sgadhiya45/Acceleration-Measurement/Simulation/Simulation_test-circuit_LT-Spice.pdf

## Simulation test circuit in LT-SPICE

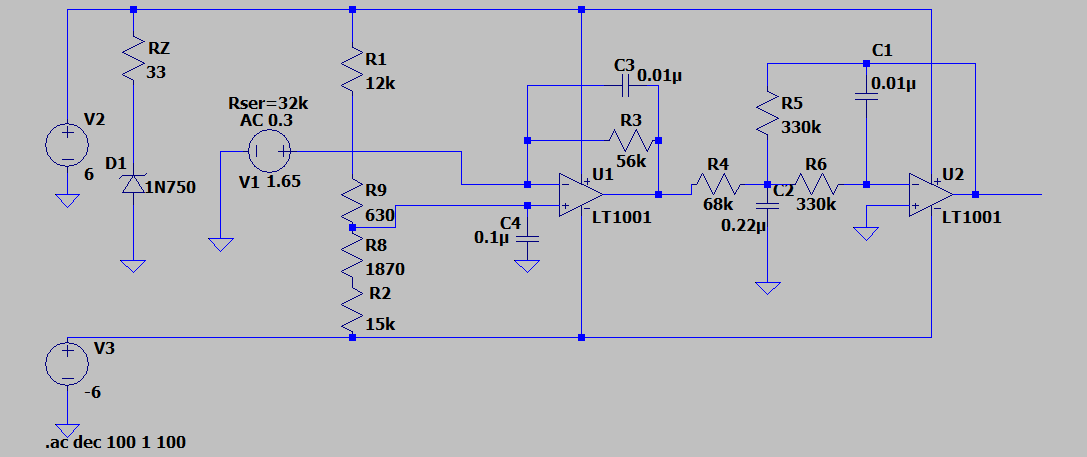
[picture p3: figure]

The simulation of circuit was done in Ltspice (from Linear Technology) software package from the SPICE family with a graphical input of circuit diagrams and a graphical output presenting the simulation results before building the circuit hardware. In place of sensor a voltage source with a series resistance Rs=32 kΩ has been used which replicates the sensor.
