sgadhiya45/Acceleration-Measurement/report/Accelerations_Measurement.pdf

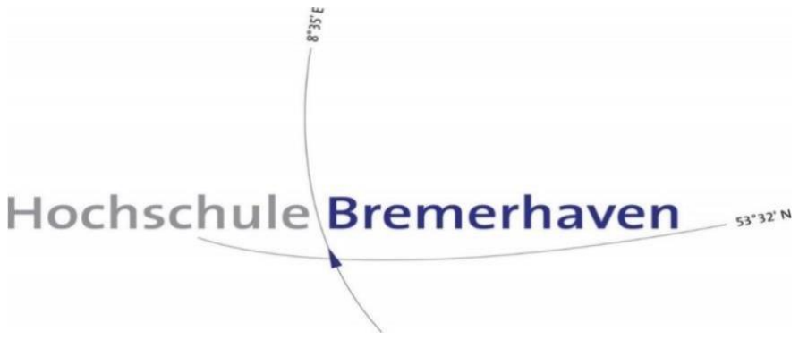
[picture p4: figure]

### M.S in Embedded Systems Design

## Maritime Systems

## Under the guidance of Prof. Dr. Axel Bochert

## Laboratory Report

## Acceleration Measurement

## Submitted by:

## Sumit Gadhiya (38710)

Date of submission: 18-09-2023

Contents

ESD Hochschule Bremerhaven | i

## Contents

Summary | 1
1. Overview | 1
2. Hardware basics | 2
2.1 | Acceleration sensor/ Sensor module | 2
2.2 | Microcontroller ATmega32 | 3
2.3 | Circuit assembly | 3
3. Measurement of the cut-off frequency | 5
3.1 | Using sine wave | 5
3.2 | Using step response | 5
4. Acceleration measurement in the elevator | 7
4.1 | Calibration process | 7
4.2 | Derivation of velocity and displacement | 9
4.3 | Correction of the temporal drift | 11
4.4 | Calculation of displacement | 12
5. Result | 13
6. Conclusion | 14
References | 15

### Abbreviation

AC : Alternating current | 5
AVR : Automatic Voltage Regulator | 3
DC : Direct Current | 5
GND : Ground | 3
PCB : Printed Circuit Board | 1
RISC : Reduced Instruction Set Computer | 3
SD card : Secure Digital Memory Card | 1
MEMS : Micro Electric Mechanical System | 3

Summary

ESD Hochschule Bremerhaven | 1

## Summary

The goal of the experiment is to calculate the height of the floors by measuring the acceleration of an elevator trip.

The experiment includes multiple phases, including designing and simulating a circuit in LTspice, creating a circuit on a PCB, programming a microcontroller, measuring acceleration data, processing it, and recording it on an SD card with the help of a microcontroller.

To improve accuracy, several elevator rides were taken and the data examined. The measurements were then shown in MATLAB, and the floor height was determined by calculating the standard deviation of all the readings.

## 1. Overview

The circuit is built using a ADXL355 [1] from Analog Devices was used to measure the acceleration. A Zener diode (BZX85C4V7) [2] used for stabilizing the direct current voltages for operating the sensor. An operational amplifier (TLC272) [3] for amplification of the output signal and also an active low pass filter. Finally, the remaining components values are calculated assuming the Amplification value suited.

Before starting with the assembly of the circuit on the Printed Circuit Board (PCB), the circuit was simulated in LTspice to observe the behavior of design with the calculated values of the components.

Once done with the LTspice simulation for observing the frequency response of the circuit as expected with the circuit components selected. The components are soldered onto a PCB. After which instead of directly placing the sensor module on the PCB, it is tested with the power supply and a designed board used for depicting the sensor output voltage.

DSOX 2002A Oscilloscope from Agilent [4] is used for measuring the frequency response and the step function.

Then the designed circuit was integrated with an ATmega 32 microcontroller [5] which uses a C-code for storing the analog data which uses an Analog to Digital Converter (ADC) to store the data in SD card. The acquired data values are sent to the RS232 to save onto the SD card.

Then with help of batteries the whole circuit is powered and the acceleration readings are collected for the height of the floors to be calculated.

Hardware basics

## 2. Hardware basics

The following hardware components were included in this experiment:

### 2.1 Acceleration sensor/ Sensor module

Analog Devices' ADXL335 [1] is the acceleration sensor utilized in the experiment. It works on the basis of a mass pendulum in a micro electric mechanical system (MEMS). When the pendulum is distracted, internal capabilities are altered, affecting the output voltage. The level of the output voltage becomes the measure of acceleration because the relative movement of the pendulum is changed by the sensor's acceleration. These two variables are proportional to one other. The ADXL335 [1] is a three-axis acceleration sensor. Only one axis is necessary in this experiment.

With a typical sensitivity of s = 300 mV
g

and a 0 g bias level of Voff = 1.5 V, the acceleration

sensor can measure static and dynamic acceleration within a full-scale range of ±3 g. It can detect gravity's static acceleration as well as dynamic acceleration caused by motion, shock, or vibration in tilt-sensing applications. Figure 1 indicates the pin connections on the sensor module.

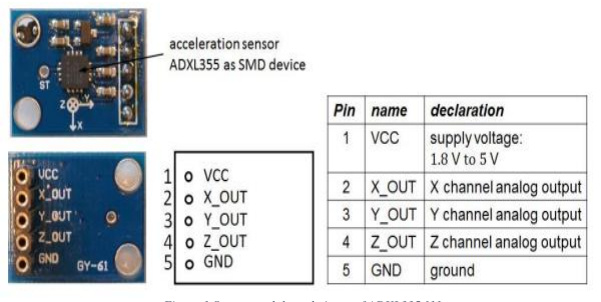
[picture p5: figure]

Figure 1 Sensor module and pinout of ADXL335 [1]

Hardware basics

### 2.2 Microcontroller ATmega32

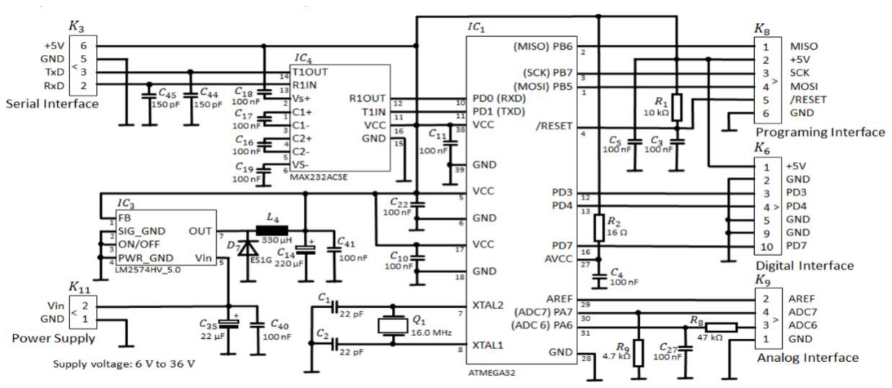
[picture p6: figure]

The Atmel® AVR® ATmega32 is a low-power CMOS 8-bit microcontroller based on the Automatic Voltage Regulator (AVR), enhanced Reduced Instruction Set Computer (RISC) architecture. In this experiment, the ATmega32 [5] microcontroller was used.
The board is suited for the experiment since it has an inbuilt 10-bit analog to digital converter (ADC), an RS232 communication port, and digital inputs and outputs. The above Figure 2 shows a circuit schematic for the microcontroller board.

### 2.3 Circuit assembly

The circuit design has two stages (see Figure 3). The former consists of subtracting amplifier and later stage is inverting amplifier and active low-pass filter. The purpose of this circuit is to measure acceleration. The offset voltage of the accelerometer in the test circuit is 1.5 V. The elevator acceleration was set to between +1.5 g and -0.5 g, resulting in a maximum output voltage of 1.95 V and a minimum output voltage of 1.35 V from the sensor.

A Zener diode provides the appropriate voltage to the sensor moduleM1. The module provides a variable output voltage on pin 2 that is proportional to X-direction acceleration. Pin 5 serves as a ground (GND) for both the power supply and the output signal. The desired amplification converting the sensor module's output voltage to the test circuit's output voltage Vacc can be shared across both amplification stages. The subtracting amplifier's positive input can be adjusted to zero to erase the sensor module's offset voltage. The trimmer P1 may be used to modify the voltage divider.

The second amplifier phase is made up of an active second-order low-pass filter with multiple negative feedback. This low-pass filters out high-frequency acceleration impulses. This is required since the Analog signal will be transformed to a digital signal later.

Figure 2 Microcontroller ATmega32 circuit diagram [2]

Hardware basics

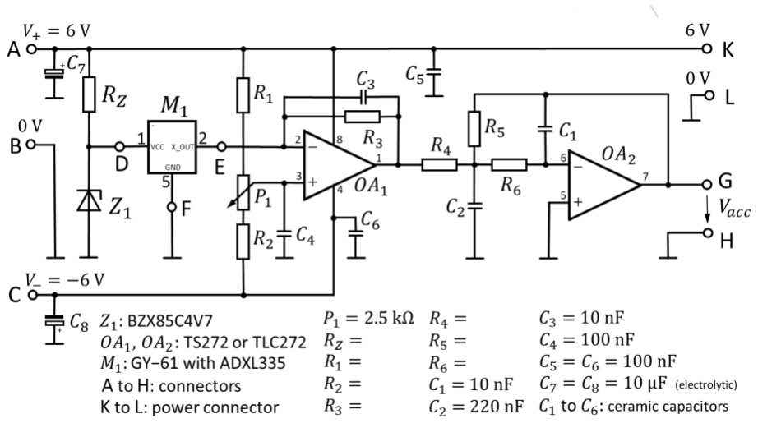
[picture p7: figure]

The power supply for the microcontroller experimental board used for data acquisition can be provided through connectors K and L. Figure 4 shows the test circuit diagram.

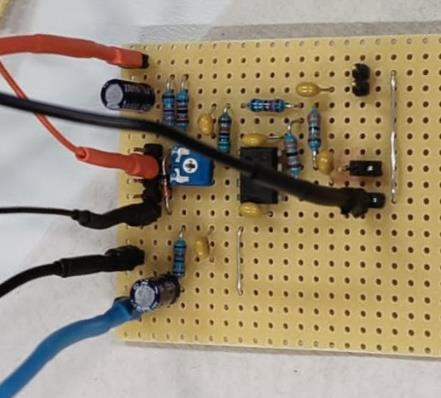
[picture p8: figure]
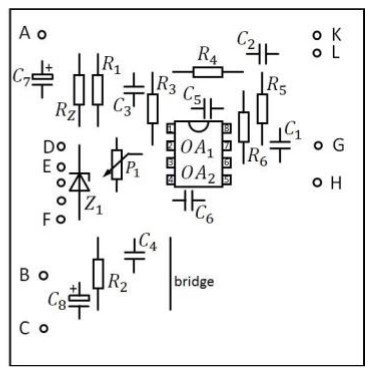
[picture p9: figure]

Figure 4: Positioning of the components on the experimental printed circuit board

Figure 3 Schematics of the test circuit with sensor module and operational amplifiers [2]

Measurement of the cut-off frequency

## 3. Measurement of the cut-off frequency

A waveform is generated with the help of an Agilent oscilloscope. There are two ways to calculate the frequency response of the circuit.
The following two approaches were used to determine the cut-off frequency.
1 Comparing the frequency response with the step response.
2 Creating a sign wave with the frequency response of a waveform generator

### 3.1 Using sine wave

An alternating current (AC) voltage is supplied to the circuit as replacement of the sensor module. The internal resistor of the sensor must be simulated using an external resistor. Then the output voltage is observed by changing the frequency.

The gain at the cut-off frequency can be derived with the direct current (DC)-gain:

gc =

g0
√2

=

7.08
√2
= 5.006 | (1)

The gain gc can be found at fc = 9.5 Hz (see Figure 5)

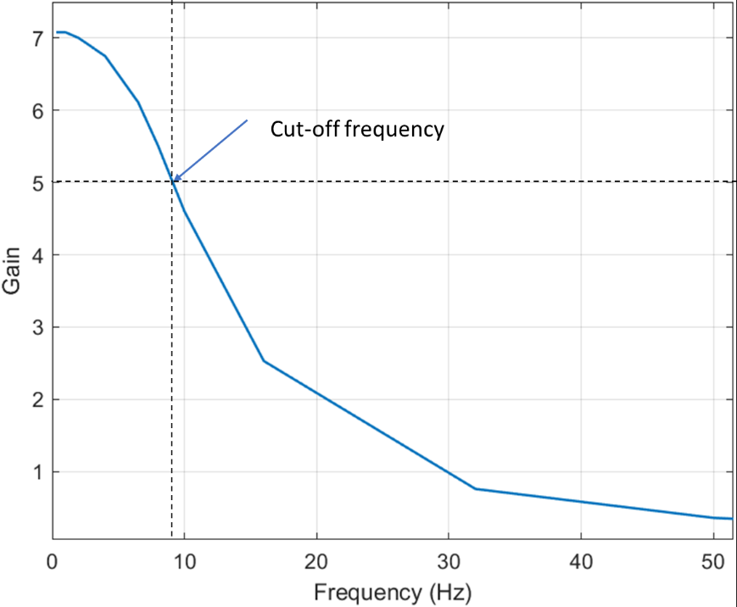
[picture p10: figure]

Figure 5 Sine wave frequency response

### 3.2 Using step response

Another way to calculate the cut-off frequency is using step response. Below diagram shows the square wave step response for the experimental circuit in oscilloscope screen.

Measurement of the cut-off frequency

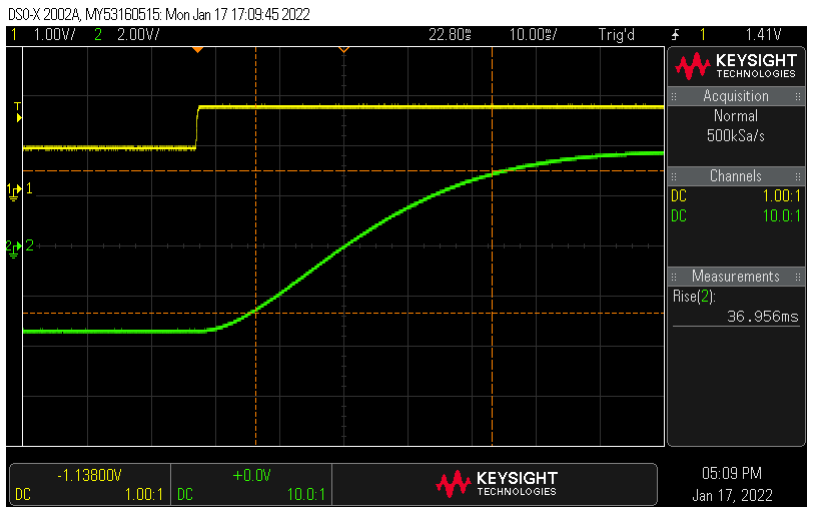
[picture p11: figure]

Slew rate ts
is the time between 10% to 90% of the output voltage which is measured automatically by the oscilloscope [4]. The cut-off frequency can be calculated as follows.

fc =

1
3∙ts

=

1
3∙36.956 ms
= 9.02 Hz | (2)

Both determination of the cut-off frequency fits into the designed cut-off frequency.

Figure 6: Step response of the experimental frequency

Acceleration measurement in the elevator

## 4. Acceleration measurement in the elevator

During the elevator travels, the battery was attached to the power supply connection on the experimental circuit. In order to achieve stability during the measurement, the experimental circuit was put and fastened with a wooden block. Using the RS232 interface, the measured data was sent and recorded to a micro-SD card. Figure 7 depicts the results of the elevator rides. After the circuit's functioning was confirmed, software measurements of acceleration during an elevator trip were recorded. In housing T of the University of Applied Sciences Bremerhaven, five elevator rides between the ground and 1

st floor were recorded. A calibration process was carried out before each journey in order to later calibrate the recorded data to the acceleration values of 0 g and 1 g.

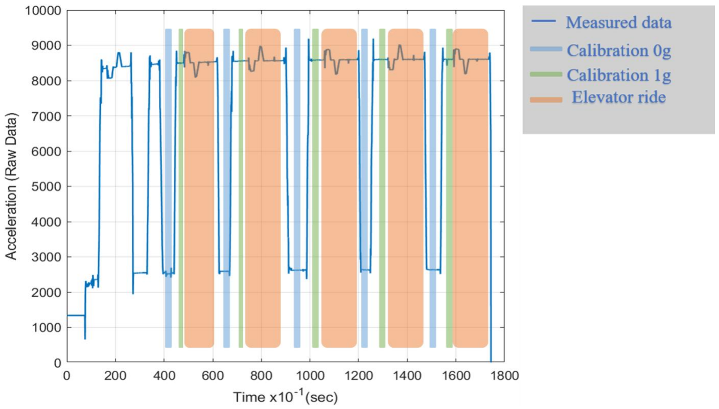
[picture p12: figure]

The first reading was discarded due to erroneous data.
a. At time 40s (color blue) acceleration due to gravity is 0 g. Sensor axis is in horizontal direction.
b. At time 43s (color green) acceleration due to gravity changes to 1 g. Sensor axis is tilted to vertical direction.
c. Between 45s to 65s (color orange section) is acceleration during elevator trip.

The following plot is repletion of the above steps. Calibration was performed after reaching every floor.

### 4.1 Calibration process

Raw data captured can’t be used directly for the calculation. The data logged contains the time and the output dacc from the ADC. This is nothing but the acceleration data in other means. Two known accelerations were collected before each trip to calibrate the recorded data.

Figure 7: Overview of recorded data

Acceleration measurement in the elevator

By tilting the sensor 90° to the floor, the first calibration point is 0 g. The sensor axis was then tilted in the direction of gravity to detect 1 g. To get a stable value, both calibration points were measured for 3 seconds. Both calibration stages were averaged arithmetically.

The below equation is used to calculate the acceleration.

a = k1 ∙ dacc + k0
(3)

Where,
a = Acceleration
k1 = co-efficient for proportionality
dacc = Output of analog to digital converter
k0 = co-efficient of the offset (m s

2 ⁄ )

By choosing two appropriate calibration sites of 0 g and 1 g, the coefficients k0 and k1 are calculated.

| Trip1 (dacc(value can be seen in tℎe raw data) )
Mean 0 g | 2550
Mean 1 g | 8596

Substituting these values in equation (4), we can derive following two equations.

For 0g: | 0 m s
2 ⁄ | = k1 ∙ 2550 + k0
(4)
For 1g: | 9.81 m s
2 ⁄ | = k1 ∙ 8842 + k0
(5)

From equation (5) and equation (6), we get,

k1 =

9.81 m s

2 ⁄
8842 − 2550 = 1.559 × 10⁻³ m/s

2

Substituting k1 we get k0
k0 = −k1 ∙ 2550 = −4.1375 m/s

2

The actual acceleration can be determined by using k0, k1, and dacc for all of the recorded values (Refer to equation 3).

Acceleration measurement in the elevator

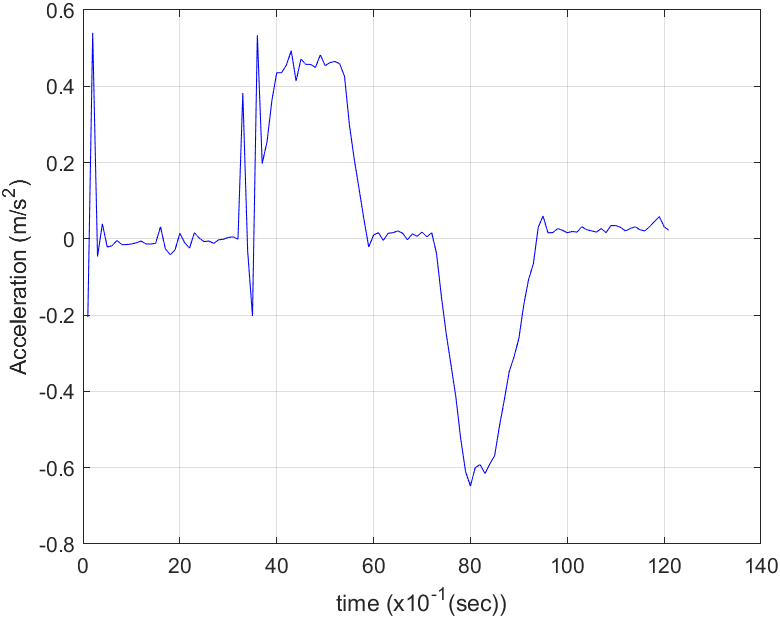
[picture p13: figure]

Figure 8 Acceleration Data

As a result, the raw acceleration data is transformed to m⁄s

2
after calibration, as illustrated in Figure 8.

The acceleration data for a single-direction movement, such as moving from the ground floor to 1

st floor, is displayed below.

### 4.2 Derivation of velocity and displacement

Using fundamental physics and mathematics concepts, the height of the floors can be computed from the acceleration data.

As we all know, an object's acceleration is defined as the rate at which its velocity changes, and velocity may be further defined as the rate at which its displacement varies over time.

The mathematical formula for acceleration (a), velocity (v), and displacement (s) are provided below.

a =

dv
dt

### and v =

ds
dt

Acceleration measurement in the elevator

From the above equations we have

v = ∫ a ∙ dt + v0

t
0

and s = ∫ v ∙ dt + s0

t
0

Where,
s0 = Initial displacement at time t = 0
v0 = Initial velocity at t = 0

Since we have discrete time systems, the above equations are replaced by summation:

vk = ∑ ai
- ∆t + v0

k
0

(6)

Where,
vk = Velocity at instance T
ai = acceleration at instance i
∆t = Time between two measurements

sk = ∑ vi
- ∆t + s0

k
0

(7)

Where,
S = Displacement at instance T
vi = acceleration at instance i
∆t = Time between two measurements

Using these equations, the velocity and the displacement can be calculated from the acceleration data acquired.
The Figure 9 shows the Velocity graph calculated from the equation (7).

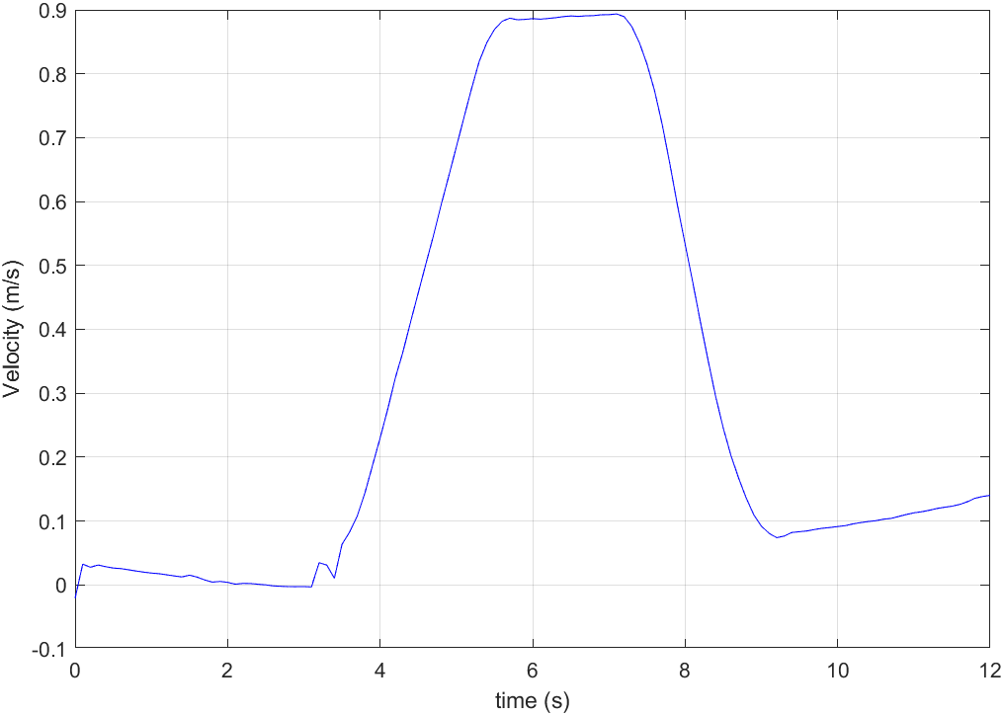
[picture p14: figure]

Figure 9 Velocity of Initial trip

Acceleration measurement in the elevator

### 4.3 Correction of the temporal drift

The velocity graph shows a temporal drift as the velocity never reaches to 0 even after elevator has stopped at time around 12s. This is because of linearly increasing error due to incorrect calibration. It is corrected by subtraction of the linearly increasing value.

m =

y2 − y1
x2 − x1

Where,
m = Slope of temporal drift yn = Velocity Coordinate
xn = Time Coordinate

m =

0.13 − 0
9.8 − 0

= 0.0132 m/s

2

Thus, by plotting the temporal drift using equation of line (y = m ∙ x), and subtracting the velocity values in Figure 9, corrected velocity graph can be plotted as shown in Figure 10 below.

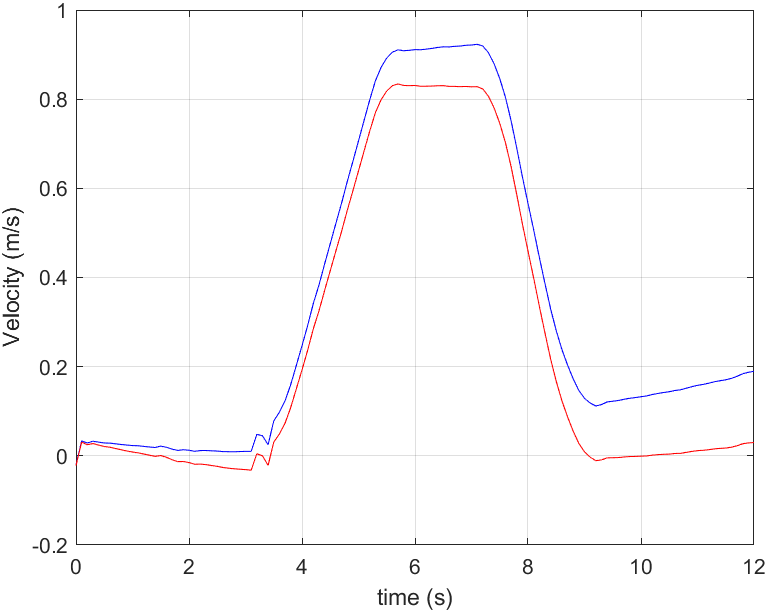
[picture p15: figure]

Figure 10: Corrected velocity during elevator trip from ground floor to third floor

Acceleration measurement in the elevator

### 4.4 Calculation of displacement

Using this equation (8), displacement s at all instances is calculated considering the velocity values from Figure 11 and Δt as 0.1 s, displacement graph is plotted for the elevator trip from ground floor to third floor as shown below.

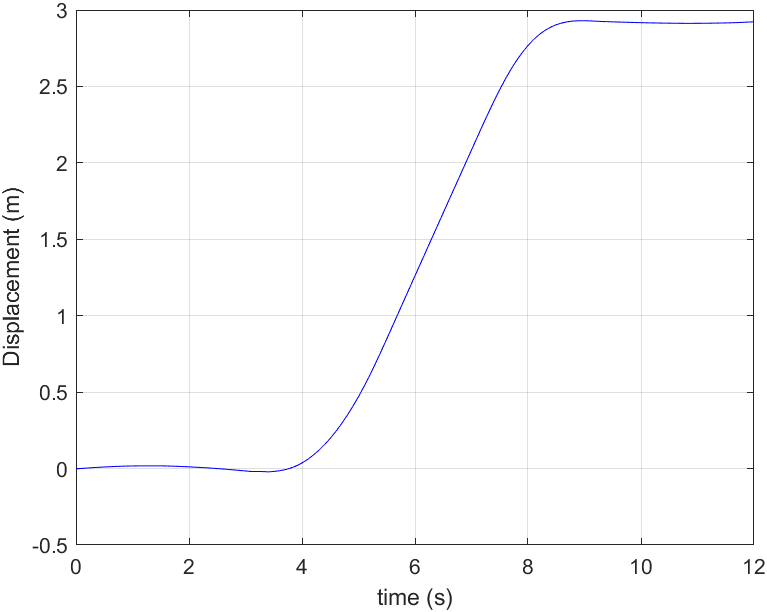
[picture p16: figure]

Figure 11 Displacement graph for the first trip

The final displacement is 2.89 m. This is the distance from ground floor to first floor.

Result

## 5. Result

The first trip was excluded as there are erroneous values seen. The below table shows the height of the floor during each trip

Trip | Height
Trip 1 (Up) | 2.89m
Trip 2 (down) | 3.25m
Trip 3 (Up) | 3.1m
Trip 4 (down) | 3.15m
Trip 5 (Up) | 3.5m

Table 1: Distance measurement during each trip

The mean distance (s̅) of all of above trip as follows:

s̅=

1
N

∑Si

5

i=1

s̅=

15.89m
5
= 3.178 m | (8)

Where,
N = Number of sample points
si = Measurement of i

tℎ point

The standard deviation can be calculated as σ = √
∑ (si − s̅)

5
1

2

N

Where,
σ is standard deviation
si = Measurement of i trips σ = 0.199 m

Conclusion

## 6. Conclusion

Overall, the experiment accomplished in monitoring the floor level using an accelerometer.

A circuit to condition the output signal of the accelerometer has been successfully calculated, constructed and tested. A suitable microcontroller program has been designed and integrated to record the data.

Finally, MATLAB was used to analyse the collected data in order to determine the floor level. With a standard variation of 0.199 m, the measured mean floor level is 3.178 m.

References

## References

[1] "Small, Low Power, 3-Axis ±3 g Accelerometer ADXL335," Norwood, MA 02062-9106, U.S.A.
[2] A. Bochert, winter Semester 2021/2022. [Online]. Available: https://elli.hs-bremerhaven.de/goto.php?target=file_243353_download&client_id=elli.
[3] T. Instruments, "Data Specification TLC227," Precision Dual Operational Amplifier, August 1994.
[4] A. Technology, "Agilent InfiniiVision 2000 X-Series Oscilloscopes," 2011.
[5] Atmel Corporation: Data Sheet ATmega32; 8-bit AVR Microcontroller with 32Kbyte In-System Programmable Flash; San Jose; Revision 2503Q-AVR-02/11; 2011.
